ExShadowZ/XYoxa/XYoxa_Schematic/MOXAv2.0-B_Cu.pdf

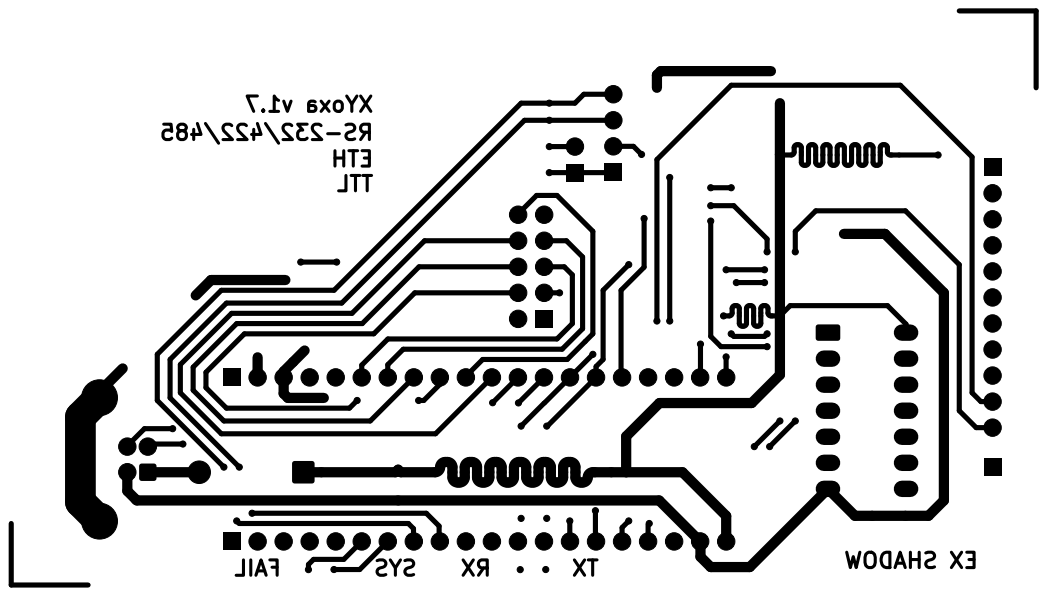
[picture p1: page 1]

SHADOW EX FAIL SYS RX TX
