ExShadowZ/XYoxa/XYoxa_Schematic/MOXAv2.0-F_Cu.pdf

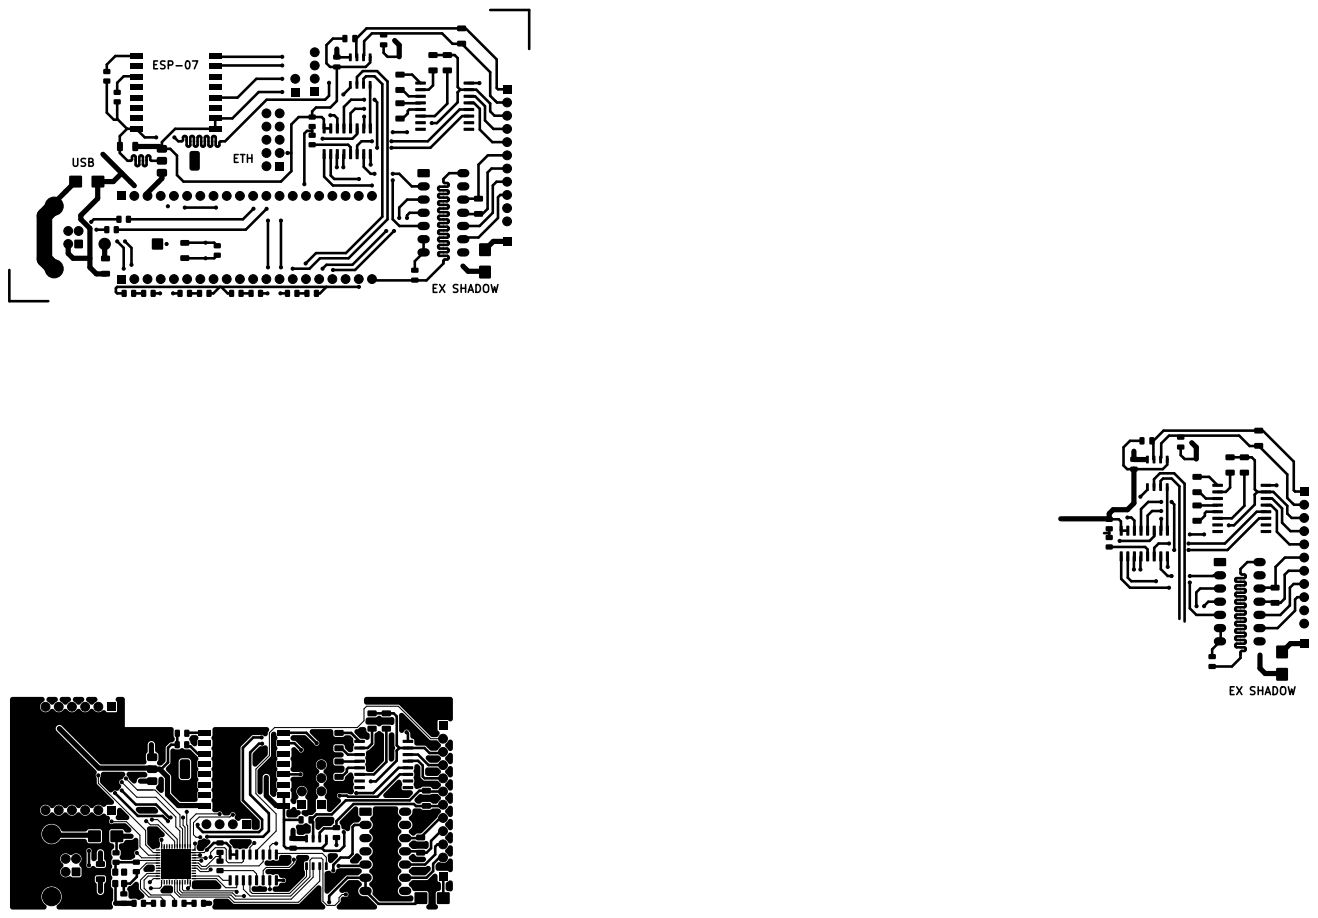
[picture p2: page 1]
