ExShadowZ/XYoxa/XYoxa_Schematic/MOXAv2.0.kicad_sch

## KiCad design XYoxa_Schematic/MOXAv2.0.kicad_sch (2026-10-17)

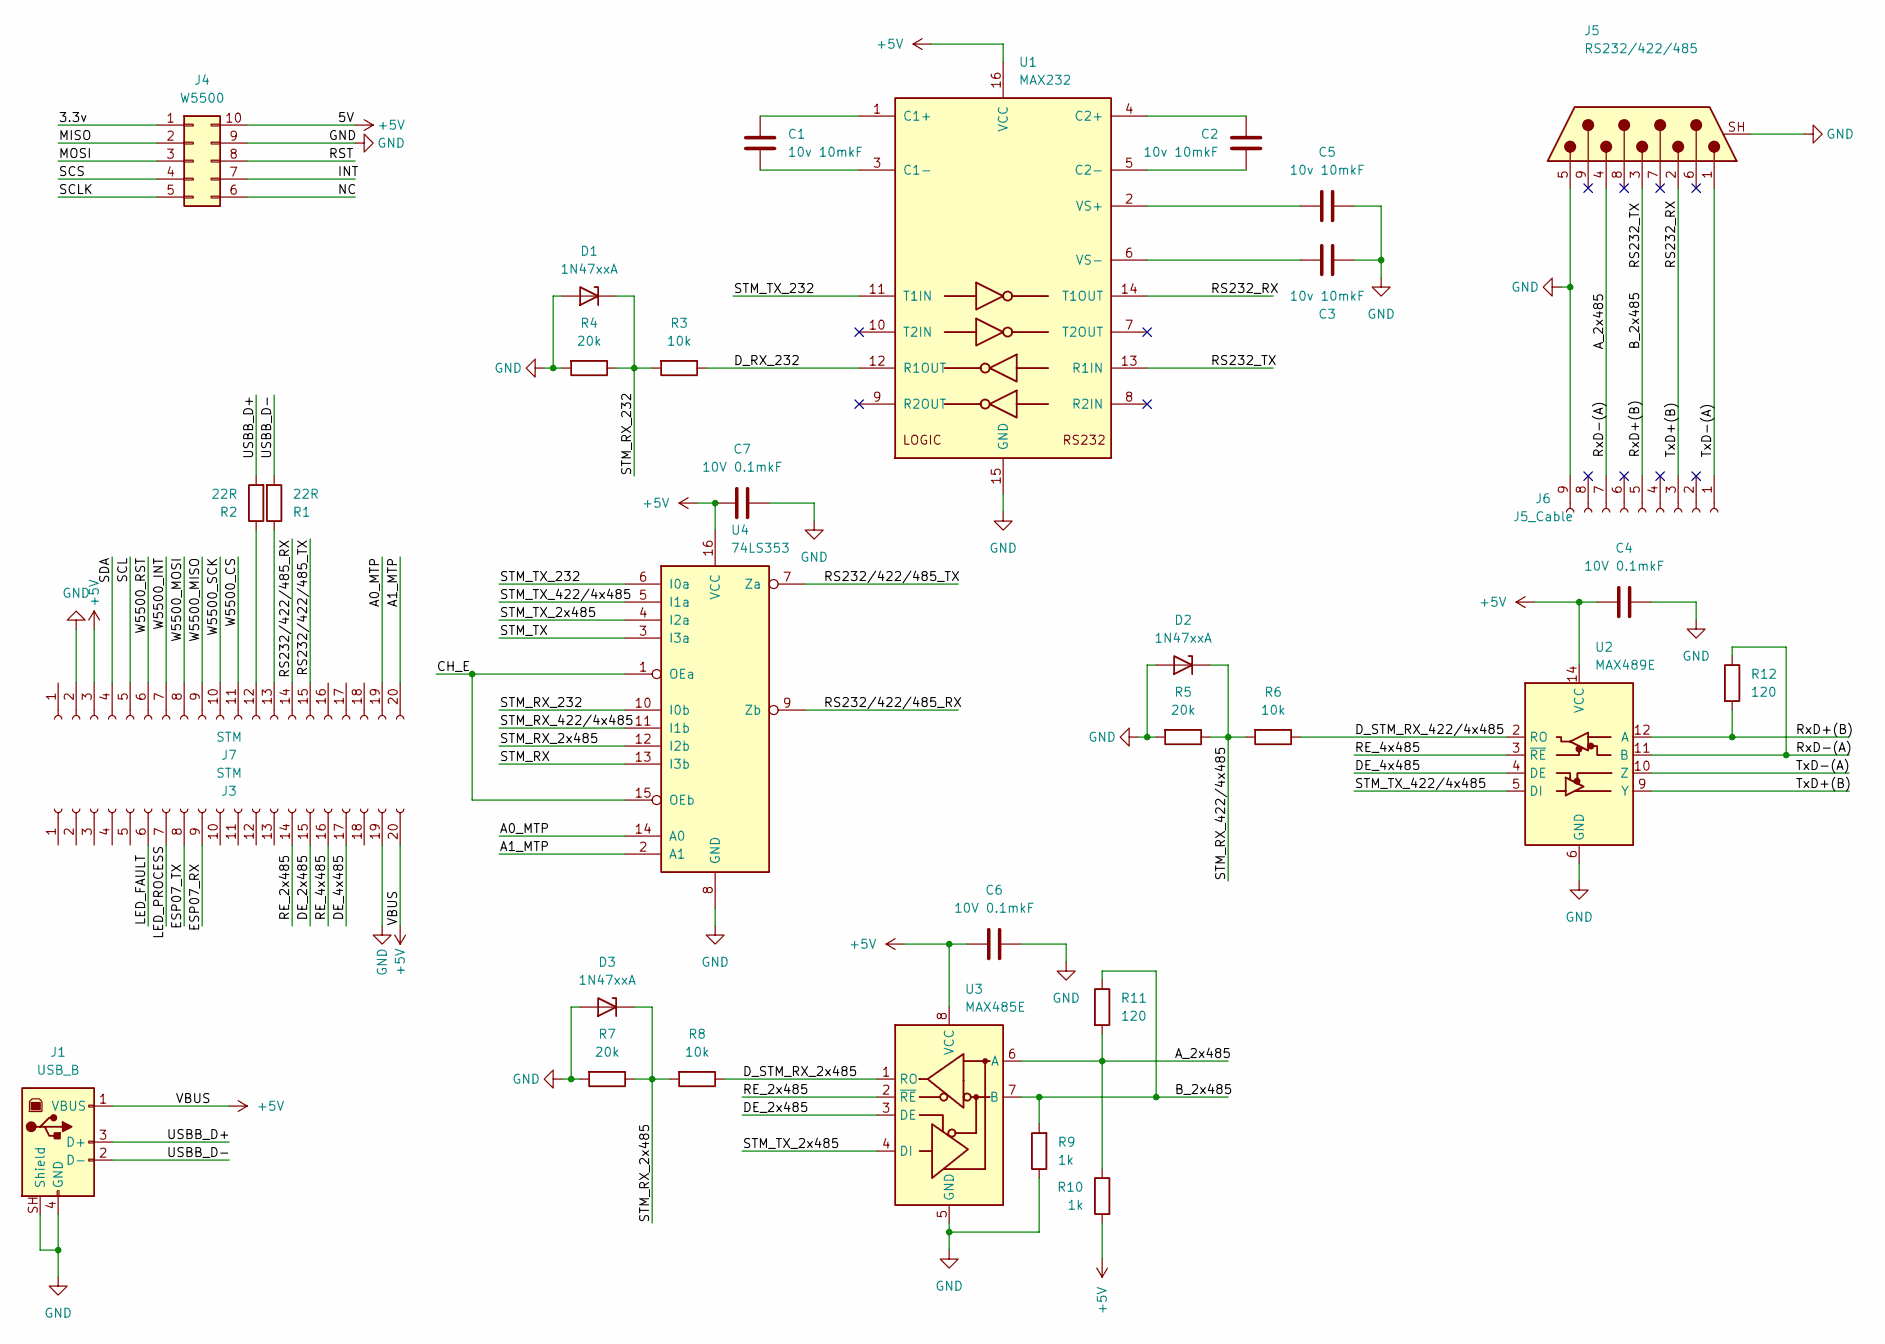
[picture p3: schematic MOXAv2.0.kicad_sch]

Parts:
C1, C2, C3, C5: 10v 10mkF; C_1206_3216Metric_Pad1.33x1.80mm_HandSolder
C4, C6, C7: 10V 0.1mkF; C_0201_0603Metric
D1, D2, D3: 1N47xxA; D_DO-41_SOD81_P10.16mm_Horizontal
J1: USB_B; USB_B_Lumberg_2411_02_Horizontal
J3, J7: STM; PinSocket_1x20_P2.54mm_Horizontal
J4: W5500; IDC-Header_2x05_P2.54mm_Vertical
J5: RS232/422/485; SOT-23-5
J6: J5_Cable; C_1206_3216Metric_Pad1.33x1.80mm_HandSolder
R1, R2: 22R; R_0805_2012Metric
R3, R6, R8: 10k; R_0805_2012Metric
R4, R5, R7: 20k; R_0805_2012Metric
R9, R10: 1k; R_0805_2012Metric
R11, R12: 120; R_1206_3216Metric
U1: MAX232; SOIC-16W_7.5x10.3mm_P1.27mm
U2: MAX489E; DIP-14_W7.62mm_Socket_LongPads
U3: MAX485E; SOIC-8_3.9x4.9mm_P1.27mm
U4: 74LS353; SOIC-24W_7.5x15.4mm_P1.27mm

Connections:
3.3v: J4.1
+5V: C4.2, C6.2, C7.2, J1.1 (VBUS), J3.20, J4.10, J7.3, R10.2, U1.16 (VCC), U2.14 (VCC), U3.8 (VCC), U4.16 (VCC)
A0_MTP: J7.19, U4.14 (A0)
A1_MTP: J7.20, U4.2 (A1)
A_2x485: J5.4, J6.7, R10.1, R11.2, R12.1, U2.11 (B), U3.6 (A)
B_2x485: J5.3, J6.5, R9.2, R11.1, R12.2, U1.13 (R1IN), U2.12 (A), U3.7 (B)
CH_E: U4.1 (OEa), U4.15 (OEb)
DE_2x485: J3.15, U3.3 (DE)
DE_4x485: J3.17, U2.4 (DE)
D_RX_232: R3.1, U1.12 (R1OUT)
D_STM_RX_2x485: R8.1, U3.1 (RO)
D_STM_RX_422/4x485: R6.1, U2.2 (RO)
ESP07_RX: J3.9
ESP07_TX: J3.8
GND: C3.2, C4.1, C5.2, C6.1, C7.1, D1.2 (A), D2.2 (A), D3.2 (A), J1.4 (GND), J1.SH (Shield), J3.19, J4.9, J5.5, J5.SH (PAD), J6.9, J7.2, R4.2, R5.2, R7.2, R9.1, U1.15 (GND), U2.6 (GND), U2.7 (GND), U3.5 (GND), U4.8 (GND)
INT: J4.7
LED_FAULT: J3.6
LED_PROCESS: J3.7
MISO: J4.2
MOSI: J4.3
NC: J4.6
unnamed: C1.1, U1.1 (C1+)
unnamed: C1.2, U1.3 (C1-)
unnamed: C2.1, U1.4 (C2+)
unnamed: C2.2, U1.5 (C2-)
unnamed: C3.1, U1.6 (VS-)
unnamed: C5.1, U1.2 (VS+)
unnamed: J7.12, R2.1
unnamed: J7.13, R1.1
RE_2x485: J3.14, U3.2 (~RE)
RE_4x485: J3.16, U2.3 (~RE)
RS232_RX: J5.2, J6.3, U1.14 (T1OUT), U2.9 (Y)
RS232/422/485_RX: J7.14, U4.9 (Zb)
RS232/422/485_TX: J7.15, U4.7 (Za)
RST: J4.8
SCL: J7.5
SCLK: J4.5
SCS: J4.4
SDA: J7.4
STM_RX: U4.13 (I3b)
STM_RX_2x485: D3.1 (K), R7.1, R8.2, U4.12 (I2b)
STM_RX_232: D1.1 (K), R3.2, R4.1, U4.10 (I0b)
STM_RX_422/4x485: D2.1 (K), R5.1, R6.2, U4.11 (I1b)
STM_TX: U4.3 (I3a)
STM_TX_2x485: U3.4 (DI), U4.4 (I2a)
STM_TX_232: U1.11 (T1IN), U4.6 (I0a)
STM_TX_422/4x485: U2.5 (DI), U4.5 (I1a)
TxD-(A): J5.1, J6.1, U2.10 (Z)
USBB_D+: J1.3 (D+), R2.2
USBB_D-: J1.2 (D-), R1.2
W5500_CS: J7.11
W5500_INT: J7.7
W5500_MISO: J7.9
W5500_MOSI: J7.8
W5500_RST: J7.6
W5500_SCK: J7.10
