ExShadowZ/XYoxa/MOXA_v2.0/Core/Src/main.c

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
/* Includes ------------------------------------------------------------------*/
#include "main.h"
#include "usb_device.h"

/* USER CODE BEGIN Includes */
#include "socket.h"
#include "wizchip_conf.h"
#include "esp_link.h"
#include "esp_commands.h"
#include "bridge.h"
#include "usb_cdc.h"
#include "rs_config.h"
#include "rs_bridge.h"
#include "eth_bridge.h"
/* USER CODE END Includes */

/* USER CODE BEGIN PD */
#define HTTP_SOCKET     0
#define PORT_TCPS		5000
#define DATA_BUF_SIZE   2048
#define HTTP_BUF_SIZE   2048
/* USER CODE END PD */

CRC_HandleTypeDef hcrc;

I2C_HandleTypeDef hi2c1;

SPI_HandleTypeDef hspi3;

UART_HandleTypeDef huart1;
UART_HandleTypeDef huart2;
DMA_HandleTypeDef hdma_usart1_tx;
DMA_HandleTypeDef hdma_usart1_rx;
DMA_HandleTypeDef hdma_usart2_tx;

/* USER CODE BEGIN PV */
wiz_NetInfo gWIZNETINFO = { .mac = {0x00, 0x08, 0xdc, 0xab, 0xcd, 0xef},
                            .ip = {192, 168, 100, 200},
                            .sn = {255, 255, 255, 0},
                            .gw = {192, 168, 100, 1},
                            .dns = {8, 8, 8, 8},
                            .dhcp = NETINFO_STATIC };

// объявления для HTTP сервера
uint8_t gHttpTxBuf[HTTP_BUF_SIZE];
uint8_t gHttpRxBuf[HTTP_BUF_SIZE];
uint8_t http_socket_list[] = {0};
/* USER CODE END PV */

void SystemClock_Config(void);
static void MX_GPIO_Init(void);
static void MX_DMA_Init(void);
static void MX_I2C1_Init(void);
static void MX_SPI3_Init(void);
static void MX_USART1_UART_Init(void);
static void MX_USART2_UART_Init(void);
static void MX_CRC_Init(void);
/* USER CODE BEGIN 0 */
/* USER CODE BEGIN 0 */
void W5500_Select(void)
{
  HAL_GPIO_WritePin(W5500_CS_GPIO_Port, W5500_CS_Pin, GPIO_PIN_RESET);
}

void W5500_Unselect(void)
{
  HAL_GPIO_WritePin(W5500_CS_GPIO_Port, W5500_CS_Pin, GPIO_PIN_SET);
}

void W5500_ReadBuff(uint8_t* buff, uint16_t len)
{
  HAL_SPI_Receive(&hspi3, buff, len, HAL_MAX_DELAY);
}

void W5500_WriteBuff(uint8_t* buff, uint16_t len)
{
  HAL_SPI_Transmit(&hspi3, buff, len, HAL_MAX_DELAY);
}

uint8_t W5500_ReadByte(void)
{
  uint8_t byte;
  HAL_SPI_Receive(&hspi3, &byte, 1, HAL_MAX_DELAY);
  return byte;
}

void W5500_WriteByte(uint8_t byte)
{
  HAL_SPI_Transmit(&hspi3, &byte, 1, HAL_MAX_DELAY);
}
/* USER CODE END 0 */

/**
  * @brief  The application entry point.
  * @retval int
  */
int main(void)
{

  /* MCU Configuration--------------------------------------------------------*/

  /* Reset of all peripherals, Initializes the Flash interface and the Systick. */
  HAL_Init();

  /* Configure the system clock */
  SystemClock_Config();

  /* Initialize all configured peripherals */
  MX_GPIO_Init();
  MX_DMA_Init();
  MX_I2C1_Init();
  MX_SPI3_Init();
  MX_USART1_UART_Init();
  MX_USART2_UART_Init();
  MX_CRC_Init();
  MX_USB_DEVICE_Init();
  /* USER CODE BEGIN 2 */
  // Сброс W5500
  HAL_GPIO_WritePin(W5500_RST_GPIO_Port, W5500_RST_Pin, GPIO_PIN_RESET);
  HAL_Delay(10);
  HAL_GPIO_WritePin(W5500_RST_GPIO_Port, W5500_RST_Pin, GPIO_PIN_SET);
  HAL_Delay(100);

  // Регистрация колбэков
  reg_wizchip_cs_cbfunc(W5500_Select, W5500_Unselect);
  reg_wizchip_spi_cbfunc(W5500_ReadByte, W5500_WriteByte);
  reg_wizchip_spiburst_cbfunc(W5500_ReadBuff, W5500_WriteBuff);

  // Инициализация буферов сокетов (2 КБ на сокет)
  uint8_t rx_tx_buff_sizes[] = {2, 2, 2, 2, 2, 2, 2, 2};
  if (wizchip_init(rx_tx_buff_sizes, rx_tx_buff_sizes) != 0)
  {
      Error_Handler();
  }

  // Установка сетевых параметров
  wizchip_setnetinfo(&gWIZNETINFO);
  ctlnetwork(CN_SET_NETINFO, (void*)&gWIZNETINFO);

  // Проверка версии чипа — если читается 0x04, значит SPI работает
  uint8_t ver = getVERSIONR();
  if (ver != 0x04)
  {
      Error_Handler();
  }

  // Индикация успеха — зажжём LED_PROCESS
  HAL_GPIO_WritePin(LED_PROCESS_GPIO_Port, LED_PROCESS_Pin, GPIO_PIN_RESET);
  HAL_GPIO_WritePin(LED_FAULT_GPIO_Port, LED_FAULT_Pin, GPIO_PIN_SET);

  esp_link_init();
  bridge_init();

  /* Всё выключено, пока не пришла команда CMD=SET */
  rs_mux_disable();       /* E0 = 1, мультиплексор выключен */
  rs_all_xcvr_off();      /* RE=1, DE=0 для 485 и 422 */
  /* USER CODE END 2 */

  /* Infinite loop */
  /* USER CODE BEGIN WHILE */
  while (1)
  {
	    HAL_GPIO_TogglePin(LED_PROCESS_GPIO_Port, LED_PROCESS_Pin);
	    eth_bridge_poll();
	    HAL_Delay(1);

    /* USER CODE END WHILE */

    /* USER CODE BEGIN 3 */
  }
  /* USER CODE END 3 */
}

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
/* USER CODE BEGIN 4 */
void HAL_UART_RxCpltCallback(UART_HandleTypeDef *huart)
{
    if (huart->Instance == USART2) {
        esp_link_on_rx_byte();
    }
}

void HAL_UART_TxCpltCallback(UART_HandleTypeDef *huart)
{
    if (huart->Instance == USART2) {
        esp_link_on_tx_done();
        bridge_on_uart2_tx_done();
    }
    else if (huart->Instance == USART1) {
        rs_bridge_on_tx_done();
    }
}
void HAL_UART_ErrorCallback(UART_HandleTypeDef *huart)
{
    if (huart->Instance == USART2) {
        esp_link_on_error();
    }
}

void HAL_UARTEx_RxEventCallback(UART_HandleTypeDef *huart, uint16_t Size)
{
    if (huart->Instance == USART1) {
        rs_bridge_on_rx_event(Size);
    }
}
/* USER CODE END 4 */
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
